rin3/Two-Radio-Band-Controller/images/Boards.PNG

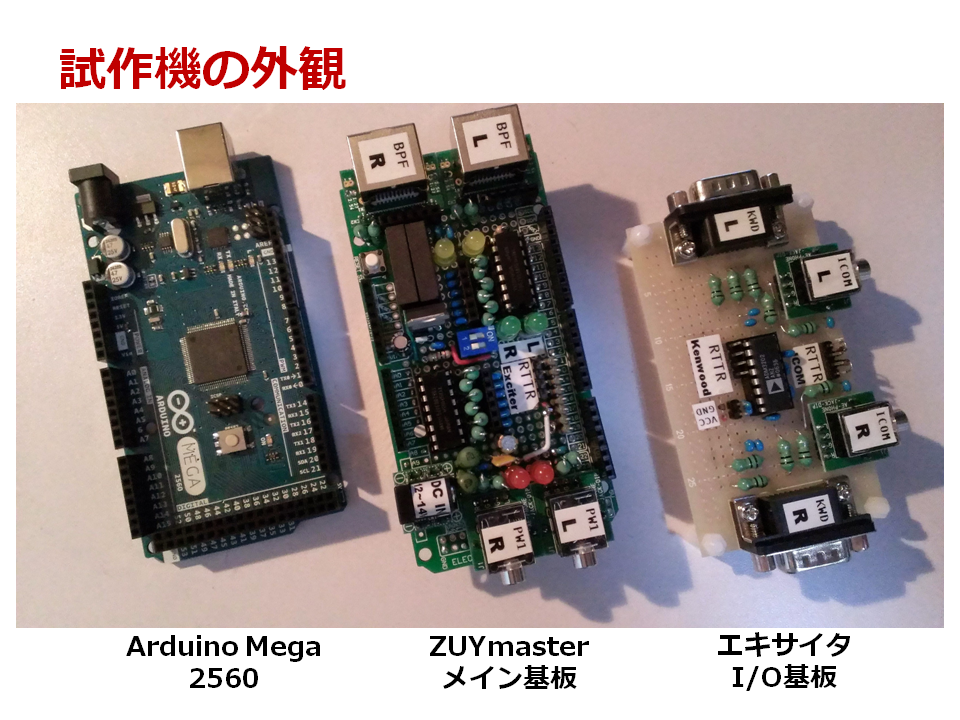
images/Boards.PNG
