rin3/Two-Radio-Band-Controller/images/ExciterIO.PNG

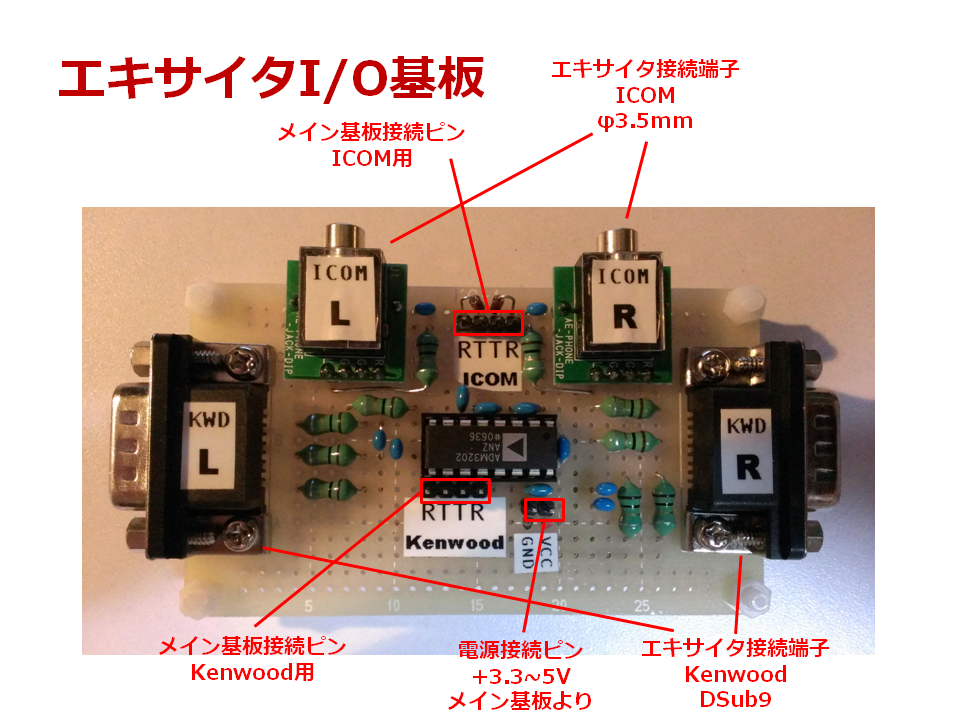
images/ExciterIO.PNG
