rin3/Two-Radio-Band-Controller/images/InUse.PNG

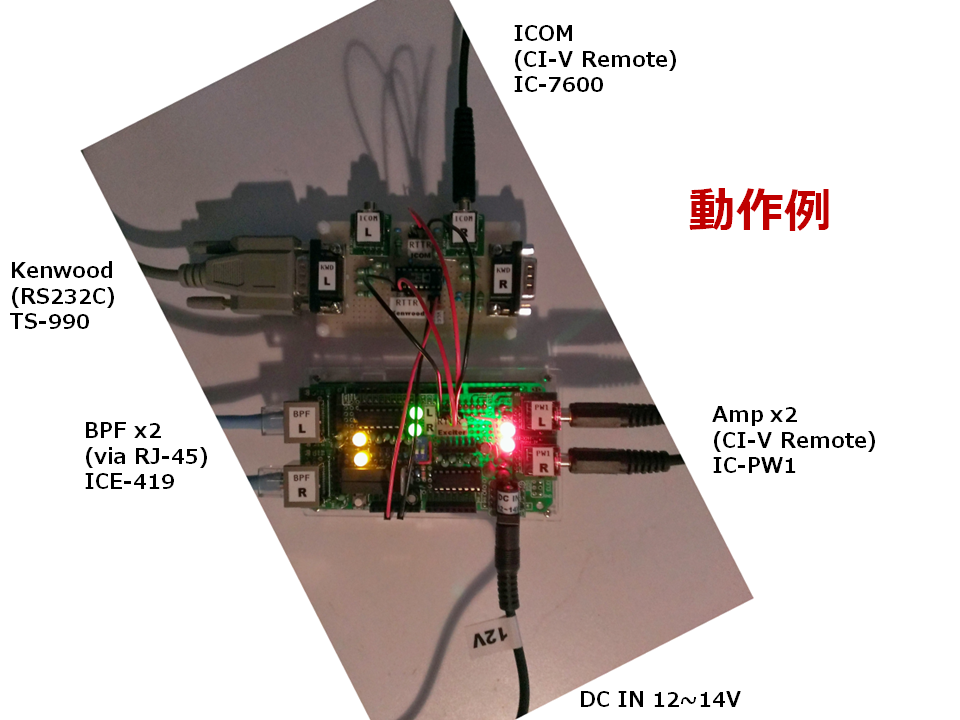
images/InUse.PNG
