rin3/Two-Radio-Band-Controller/images/LED-a.PNG

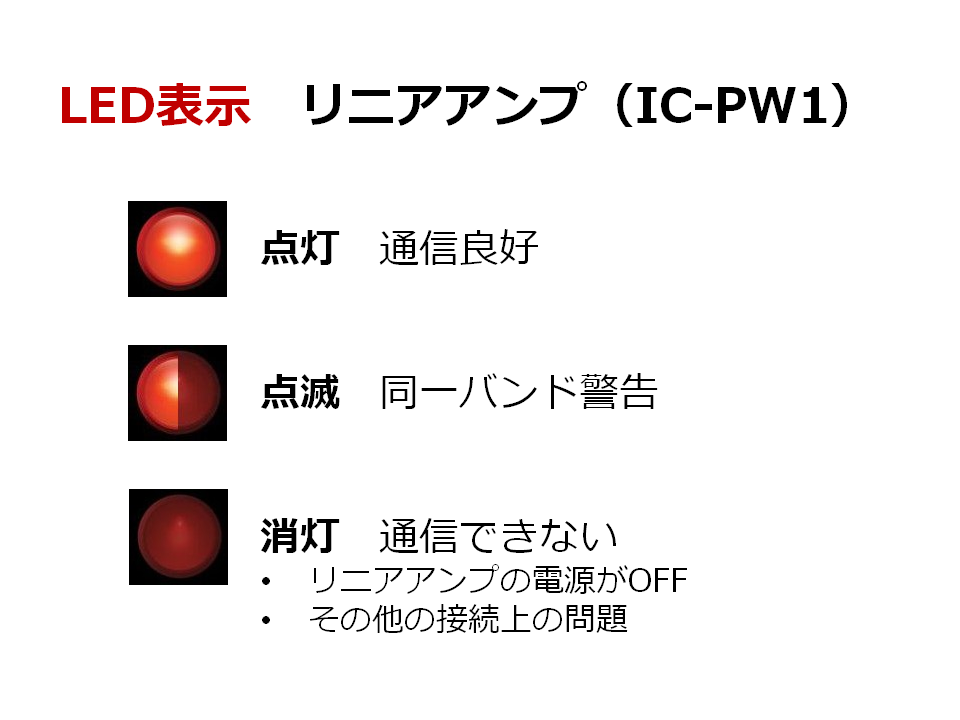
images/LED-a.PNG
