rin3/Two-Radio-Band-Controller/images/LED-b.PNG

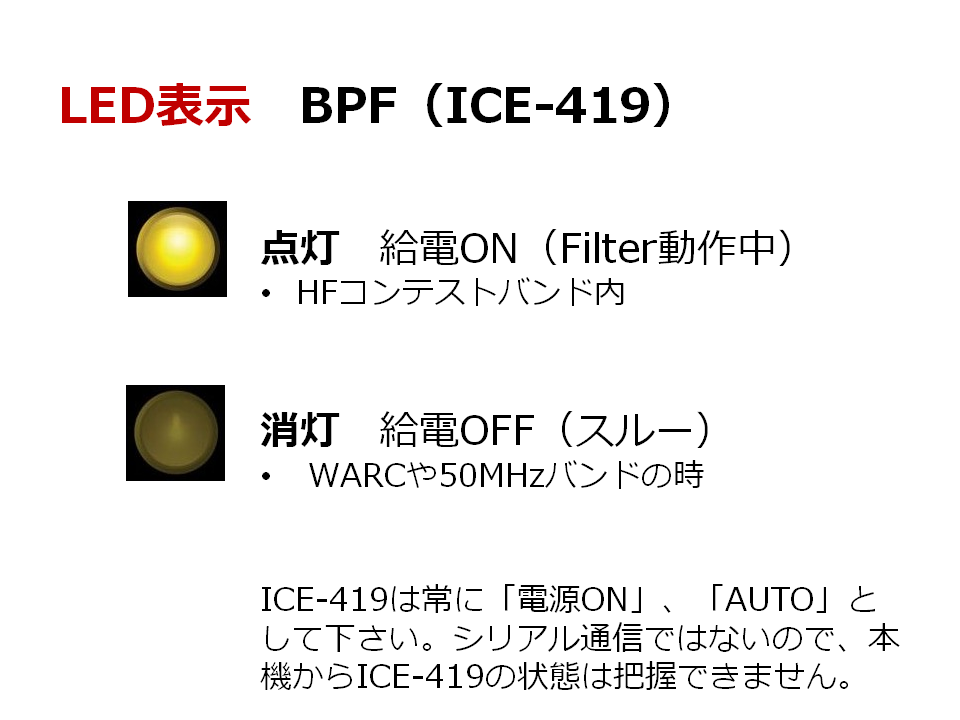
images/LED-b.PNG
