rin3/Two-Radio-Band-Controller/images/LED-e.PNG

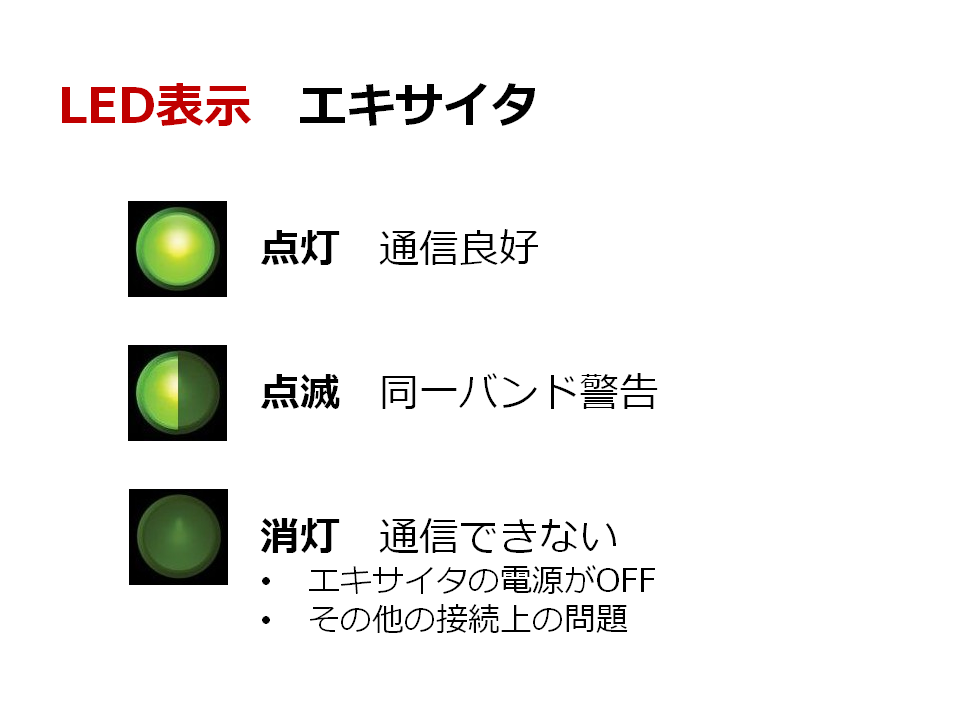
images/LED-e.PNG
