rin3/Two-Radio-Band-Controller/images/MainShield.PNG

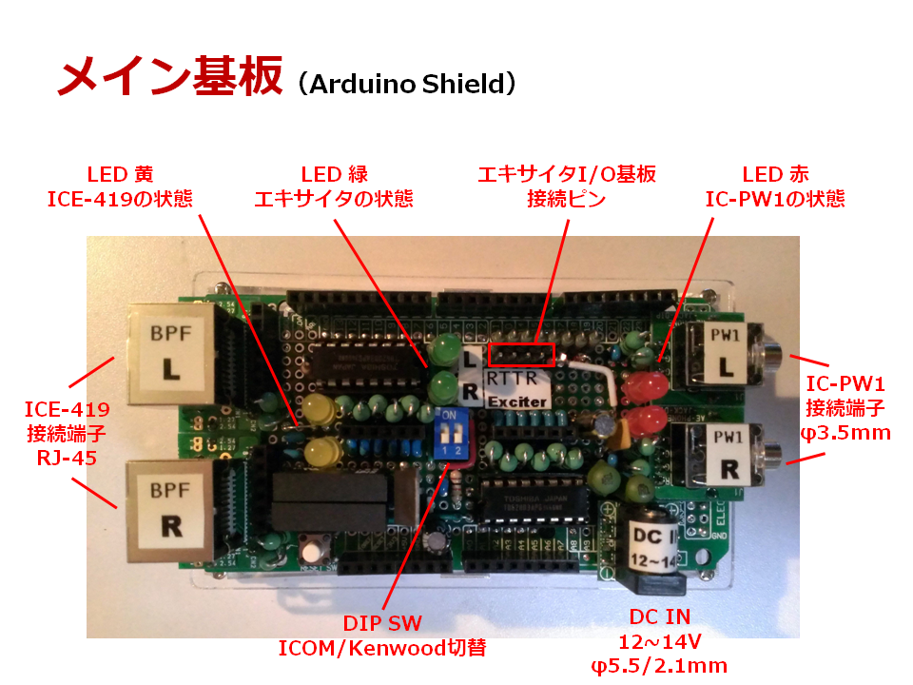
images/MainShield.PNG
