rin3/Two-Radio-Band-Controller/schematics/ZUYmaster_schematic_v1.png

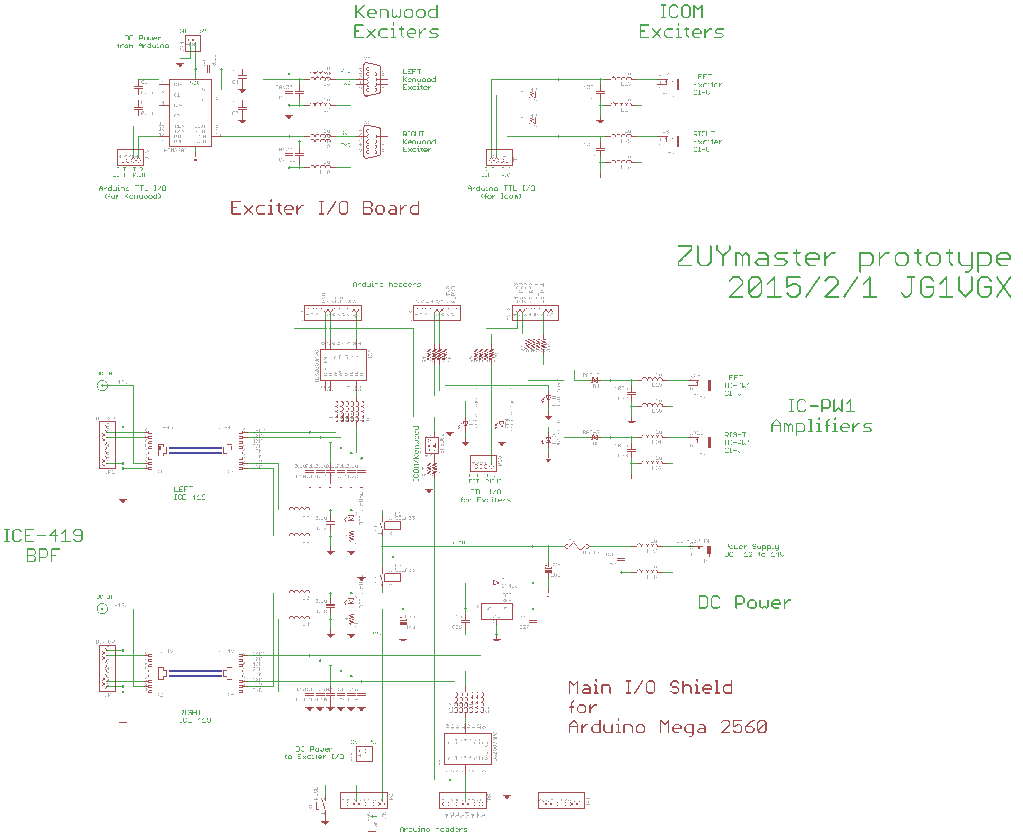
schematics/ZUYmaster_schematic_v1.png
