rin3/Two-Radio-Band-Controller/sources/ZUYmaster/ZUYmaster.ino

#include "RigUtil.h"

// switch environment, test @MEGURO or real
#define MEGURO
/*
	ZUYmaster
 	- a two radio band controller -
 
 	A band controller designed for use with two radio HF contesting environment such as SO2R, M/S and M/2.
 
 	Please set Transceive OFF for your ICOM radios.
 
 	Limitations:
 	This implimentation only works for a combination of two each of newer Kenwood/ICOM exciters, ICE-419B band pass filters and ICOM IC-PW1 amplifiers.
 	
 	The circuit consists of three boards:
 	1 - Arduino Mega 2560 board
 	1 - A Mega shield PCB with BPF I/F and IC-PW1 I/O
 	1 - Another PCB for exciter (Kenwood/ICOM) I/O
 
 	Arduino Mega I/O pins used:
 	* Digital Input (2)
 	  12 - DIP switch - L Exciter Kenwood/ICOM selection
 	  A1 - DIP switch - R Exciter Kenwood/ICOM selection
 	* Digital Output (18)
 	   5 - LED(green) - L Exciter status
 	   4 - LED(green) - R Exciter status
 	   2 - LED(red) - L IC-PW1 status
 	   3 - LED(red) - R IC-PW1 status
 	   7 - Tr array - L ICE-419 160m
 	   8 - Tr array - L ICE-419 80m
 	   9 - Tr array - L ICE-419 40m
 	  10 - Tr array - L ICE-419 20m
 	  11 - Tr array - L ICE-419 15m
 	  13 - Tr array - L ICE-419 10m
 	  A2 - Tr array - R ICE-419 160m
 	  A3 - Tr array - R ICE-419 80m
 	  A4 - Tr array - R ICE-419 40m
 	  A5 - Tr array - R ICE-419 20m
 	  A6 - Tr array - R ICE-419 15m
 	  A7 - Tr array - R ICE-419 10m
 	   6 - reed relay - L ICE-419 power control
 	  A0 - reed relay - R ICE-419 power control
 	* Communications (4x2)
 	   0/Rx, 1/Tx - Serial  - L Exciter
 	  15/Rx,14/Tx - Serial3 - R Exciter
 	  19/Rx,18/Tx - Serial1 - L IC-PW1
 	  17/Rx,16/Tx - Serial2 - R IC-PW1
 
 	Created 4 Feb 2015
 	rin JG1VGX (jg1vgx@jarl.com)
 
 	http://github.com/rin3/ZUYmaster
 */

///////////////////////////////
// Constants
///////////////////////////////

// loop iteration delay time (msec)
const int DELAY = 80;    // 20 is way too short, 50 is ok, 200 seems clumsy

// LED modes
const byte LED_OFF = 0;
const byte LED_ON = 1;
const byte LED_SLOW_BLINK = 2;
const byte LED_FAST_BLINK = 3;

// LED blink intervals
// each value must be greater than DELAY for it to work as intended
const unsigned long FAST_BLINK = 500;      // ON and OFF times are equal
const unsigned long SLOW_BLINK_ON = 100; 
const unsigned long SLOW_BLINK_OFF = 900;

// Exciters I/F
// Communication: Serial/L, Serial3/R
const byte MAKE_PIN[2] = {    // Kenwood/ICOM selection L,R pins
  12, A1};
const byte EXC_LED[2] = {    // status LEDs L,R pins
  5, 4};
const byte EXC_HEX[2] = { 
#ifdef MEGURO
  0x7C, 0x7C      // test w/IC-9100
#else
  0x7A, 0x7A      // real IC-7600
#endif
};
const int EXC_SPEED[2] = {   // COM speed L,R
  9600, 9600};
const int KENWOOD_PARAM = SERIAL_8N1;  // serial communcation parameters
const int ICOM_PARAM = SERIAL_8N1;
const int YAESU_PARAM = SERIAL_8N2;

// IC-PW1 I/F
// Communication: Serial1/L, Serial2/R
const byte AMP_LED[2] = {    // status LEDs L,R pins
  2, 3};
const byte AMP_HEX[2] = { 
  //  0x54, 0x54};               // default
  0x00, 0x00};               // better to use broadcast to inhibit PW1's Asynchronous 10 sec polls
const int AMP_SPEED[2] = {   // COM speed L,R
  9600, 9600};

// ICE-419 I/F
const byte BPF_PWR[2] = {    // powering relay L,R pins
  6, A0};
const byte BPF[2][6] = {    // band control pins
  {
    7, 8, 9, 10, 11, 13                                                                                      }      // 160,80,40,20,15,10m/L
  ,
  {
    A2, A3, A4, A5, A6, A7                                                                                      }   // 160,80,40,20,15,10m/R
};
const int BPF_BANDS[10] = {
  // corresponding the array index above, NO_MATCH is for WARC, 6m
  0, 1, 2, NO_MATCH, 3, NO_MATCH, 4, NO_MATCH, 5, NO_MATCH};

// ICOM HEX code for ZUYmaster
//const byte ZUY_HEX = 0xE0;  // PC
const byte ZUY_HEX = 0x7A;    // IC-7600 for compatibility reasons

///////////////////////////////
// Variables
///////////////////////////////

// Exciters
byte bMake[2];    // make: Kenwood = 0, ICOM = 1, Yaesu = 2
long lFreq[2];    // frequency
int iBand[2];     // band

// LED blinking control
byte excLEDMode[2] = {      // 0 = OFF, 1 = ON, etc as defined in constants
  LED_OFF, LED_OFF};
byte ampLEDMode[2] = {
  LED_OFF, LED_OFF};
byte excLEDState[2] = {     // set initial states
  LOW, LOW};  // green
byte ampLEDState[2] = {
  LOW, LOW};  // red
unsigned long lastMillisFast;        // holds start of the last blink in millis for measuring intervals
unsigned long elapMillisFast;        // holds elapsed millis since the start
unsigned long lastMillisSlow;
unsigned long elapMillisSlow;

// Pointers
HardwareSerial *pExcSer[2], *pAmpSer[2];
RigUtil *pExc[2], *pAmp[2];

///////////////////////////////
// Setup 
///////////////////////////////

void setup() {
  // pin modes
  for (int i = 0; i < 2; i++) {
    pinMode(MAKE_PIN[i], INPUT_PULLUP);
    pinMode(EXC_LED[i], OUTPUT);
    pinMode(AMP_LED[i], OUTPUT);
    pinMode(BPF_PWR[i], OUTPUT);
    for (int j = 0; j < 6; j++)
      pinMode(BPF[i][j], OUTPUT);
  }

  // put LEDs OFF, BPF PWR off
  for (int i = 0; i < 2; i++) {
    digitalWrite(EXC_LED[i], LOW);
    digitalWrite(AMP_LED[i], LOW);
    digitalWrite(BPF_PWR[i], LOW);
  }

  // read Make DIPSW
  for (int i = 0; i < 2; i++)
    if (digitalRead(MAKE_PIN[i]) == HIGH)
      bMake[i] = KENWOOD;
    else
      bMake[i] = ICOM;

  // set HardwareSerial pointers
  pExcSer[0] = &Serial;
  pExcSer[1] = &Serial3;
  pAmpSer[0] = &Serial1;
  pAmpSer[1] = &Serial2;

  // create rig objects and start communication
  for (int i = 0; i < 2; i++) {
    // exciter
    if (bMake[i] != ICOM) {
      // Kenwood or Yaesu
      pExc[i] = new RigUtil(pExcSer[i], EXC_SPEED[i], KENWOOD_PARAM, bMake[i]);
    } 
    else {
      // ICOM
      pExc[i] = new RigUtil(pExcSer[i], EXC_SPEED[i], ICOM_PARAM, bMake[i], EXC_HEX[i], ZUY_HEX);
    }

    // amplifier
    pAmp[i] = new RigUtil(pAmpSer[i], AMP_SPEED[i], ICOM_PARAM, ICOM, AMP_HEX[i], ZUY_HEX);
  }

  // initialise blink timers
  lastMillisFast = lastMillisSlow = millis();
}

///////////////////////////////
// Loop 
///////////////////////////////

void loop() {
  // for each side of radios, BPFs and amplifiers
  for (int i = 0; i < 2; i++) {
    // read exciter frequency
    lFreq[i] = pExc[i]->getFreq();

    // put exciter LED
    if (lFreq[i] != NOFREQ)
      excLEDMode[i] = LED_ON;
    else
      excLEDMode[i] = LED_OFF;

    // get band index (0..9), cf.BANDS[10][3] array in RigUtil.h
    iBand[i] = pExc[i]->getBand(lFreq[i]);

    // control BPF
    int iPosit;
    if (iBand[i] != NO_MATCH) {
      // HF or 6m (incl. WARC) band
      iPosit = BPF_BANDS[iBand[i]];
    } 
    else {
      iPosit = NO_MATCH; 
    }
    setBPFRelays(i, iPosit);

    // set amplifier band and put LED
    ampLEDMode[i] = LED_OFF;
    if (lFreq[i] != NOFREQ)
      if (pAmp[i]->setFreq(lFreq[i]) == true)
        ampLEDMode[i] = LED_ON;
  }

  // check for abberant band status ('out of band' and band clashing) and put LEDs blink accordingly
  for (int i = 0; i < 2; i++) {
    if (excLEDMode[i] == LED_ON) {
      // this side of exciter responded with freq
      if (iBand[i] == NO_MATCH) {
        // out of ham bands of interest
        excLEDMode[i] = LED_SLOW_BLINK;    // both exciter and amplifier LEDs will slow blink
        ampLEDMode[i] = LED_SLOW_BLINK;
      } 
      // inside ham bands of interest
      else if (iBand[0] == iBand[1]) {  // this part redundantly runs twice for each i (0,1)
        // bands clash!!
        excLEDMode[0] = excLEDMode[1] = LED_FAST_BLINK;
        ampLEDMode[0] = ampLEDMode[1] = LED_FAST_BLINK;
      }
    }
  }

  // actually put LEDs
  elapMillisFast = millis() - lastMillisFast;
  elapMillisSlow = millis() - lastMillisSlow;
  putLEDs(EXC_LED, excLEDMode, excLEDState);
  putLEDs(AMP_LED, ampLEDMode, ampLEDState);

  delay(DELAY);
}

///////////////////////////////
// Functions 
///////////////////////////////

// set BPF band relays
void setBPFRelays(int iSide, int iPosit) {
  if (iPosit != NO_MATCH) {
    // HF contest band
    digitalWrite(BPF_PWR[iSide], HIGH);     // power on BPF
    for (int j = 0; j < 6; j++) {
      if (j == iPosit)
        digitalWrite(BPF[iSide][j], HIGH);  // switch on the band at BPF
      else
        digitalWrite(BPF[iSide][j], LOW);   // switch off other bands
    } 
  } 
  else {
    // outside HF contest bands (incl. WARC, 6m)
//    for (int j = 0; j < 6; j++) {
//      digitalWrite(BPF[iSide][j], LOW);     // switch off all relays
//    }
    digitalWrite(BPF_PWR[iSide], LOW);      // power off BPF
  }
}

// LED control (incl. blinking)
void putLEDs(const byte *pLEDs, byte *pModes, byte *pStates) {
  if (pModes[0] == LED_FAST_BLINK) {
    // for fast blinks, do jobs for both LEDs at the same time
    if (elapMillisFast < FAST_BLINK) {
      pStates[0] = HIGH;
      pStates[1] = LOW;
      digitalWrite(pLEDs[0], HIGH);  // turn on L LED for a blink
      digitalWrite(pLEDs[1], LOW);   // turn off R LED for a blink
    } 
    else if (elapMillisFast >= FAST_BLINK && elapMillisFast < 2 * FAST_BLINK) {
      pStates[0] = LOW;
      pStates[1] = HIGH;
      digitalWrite(pLEDs[0], LOW);   // turn off L LED for a blink
      digitalWrite(pLEDs[1], HIGH);  // turn on R LED for a blink
    } 
    else if (elapMillisFast >= 2 * FAST_BLINK) {
      lastMillisFast = millis();
    }
  } 
  else {
    // either LED_OFF, LED_ON or LED_SLOW_BLINK
    // do separately for each side
    for (int i = 0; i < 2; i++) {
      switch (pModes[i]) {
      case LED_OFF:
        digitalWrite(pLEDs[i], LOW);
        break;
      case LED_ON:
        digitalWrite(pLEDs[i], HIGH);
        break;
      case LED_SLOW_BLINK:
        if (elapMillisSlow < SLOW_BLINK_ON) {
          pStates[i] = HIGH;
          digitalWrite(pLEDs[i], HIGH);  // turn on for a blink
        } 
        else if (elapMillisSlow >= SLOW_BLINK_ON && elapMillisSlow < SLOW_BLINK_ON + SLOW_BLINK_OFF) {
          pStates[i] = LOW;
          digitalWrite(pLEDs[i], LOW);   // turn off for a blink
        } 
        else if (elapMillisSlow >= SLOW_BLINK_ON + SLOW_BLINK_OFF) {
          lastMillisSlow = millis();
        }
        break;
      }
    }
  }
}
